NameCeasar/VWA/README.md

# VWA
A RaspberryPI-based robot controller board
