NameCeasar/VWA/RES/raspi_pinout.txt

02 I2C (alt)
03 I2C (alt)
04 --
05 SPI4 CS (out)
06 DP CS (out)
07 SPI3 CS (out)
08 BNO INT (in)
09 SPI (alt)
10 SPI (alt)
11 SPI (alt)
12 PWM1 (alt)
13 PWM2 (alt)
14 UART (alt)
15 UART (alt)
16 UI (in)
17 SPI1 CS (out)
18 MEGA RST (out)
19 DP DC (out)
20 UI (in)
21 UI (in)
22 MEGA CS (out)
23 --
24 LED1 (out)
25 LED2 (out)
26 UI (in)
27 SPI2 CS (out)
