NameCeasar/VWA/(list of files, drawings)

Other design files:
PCB/vwa_pi.lay6
