NameCeasar/VWA/(commit log)

2020-09-24 GPIO & Timer + VWA version backup
2020-10-04 ATmega done + ADC + IO + SPI + raspipinout
2020-10-31 PWM + UART
2020-12-02 UART fix + Meeting 2. 12
2020-12-12 New Progress (I2CDevice.h still in work)
2020-12-13 I2C Working, BNO-Test & int to string
2021-01-01 Added res + fixes
    [main.cpp]
